ThFischer/OpenSprinkler-Firmware/NodeMCU-74HC595/hardware/74HC595-adapter/F.Cu.pdf

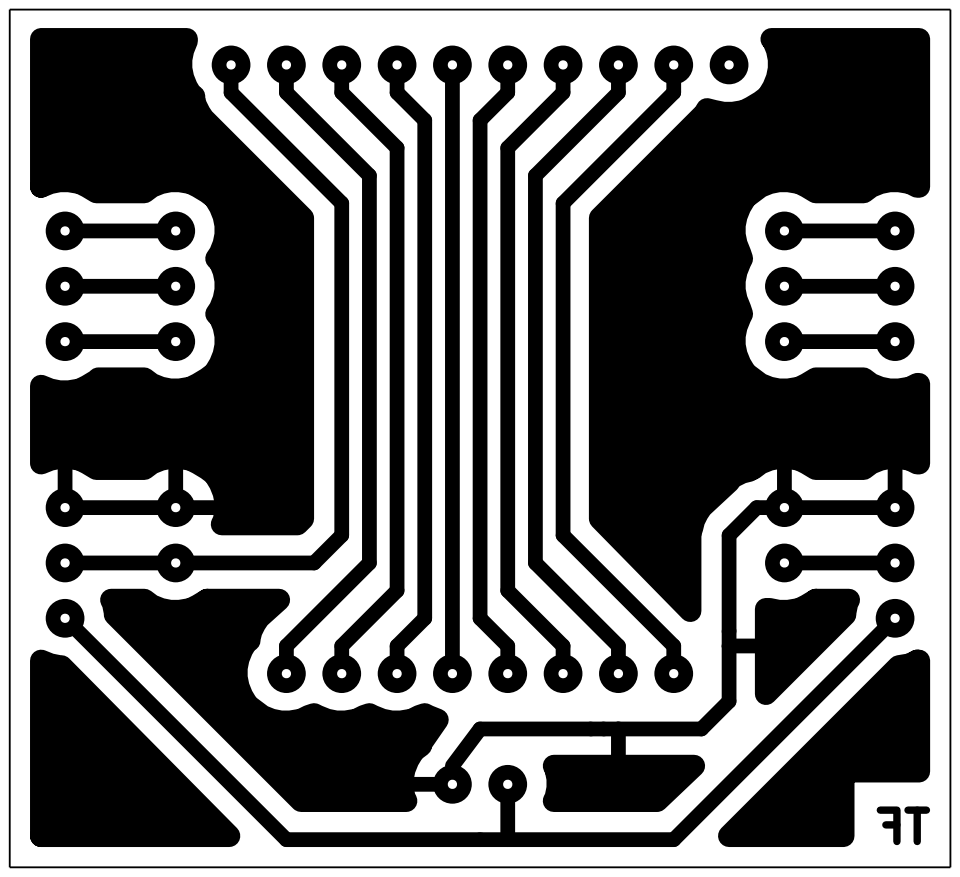
[picture p3: page 1]
