ThFischer/OpenSprinkler-Firmware/NodeMCU-74HC595/hardware/74HC595-adapter/F.SilkS.pdf

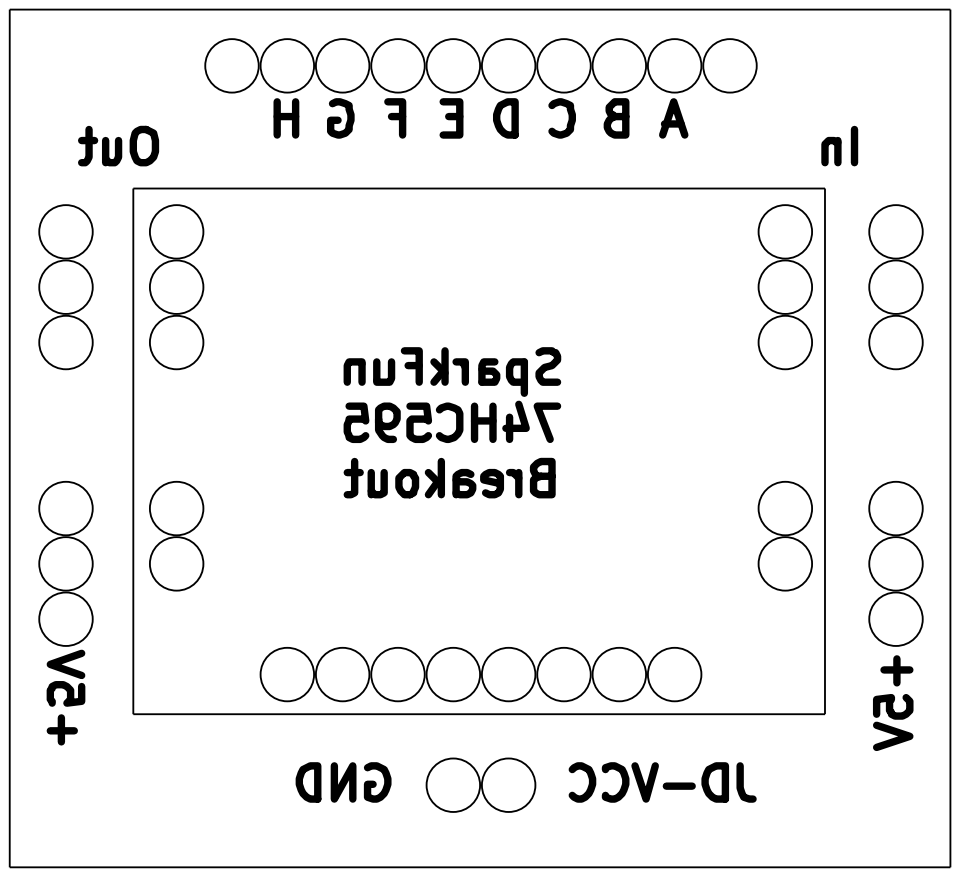
[picture p4: page 1]
