ThFischer/OpenSprinkler-Firmware/NodeMCU-74HC595/hardware/mainboard/B.Cu.pdf

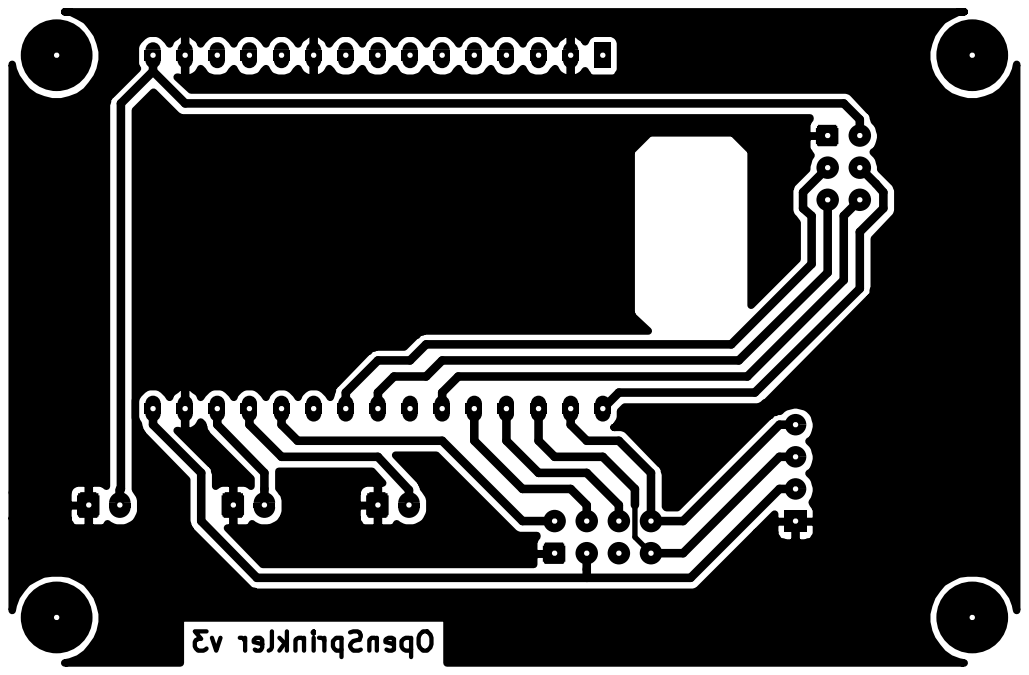
[picture p5: page 1]
