ThFischer/OpenSprinkler-Firmware/NodeMCU-74HC595/hardware/mainboard/F.SilkS.pdf

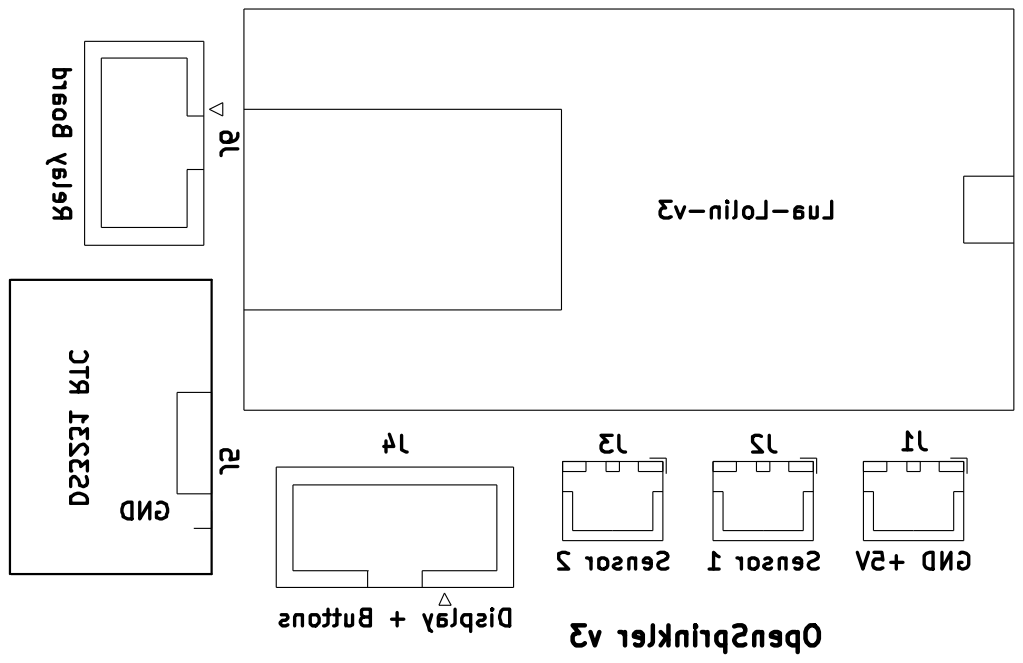
[picture p6: page 1]
