ThFischer/OpenSprinkler-Firmware/NodeMCU-74HC595/hardware/mainboard/mainboard.kicad_pcb

## KiCad design NodeMCU-74HC595/hardware/mainboard/mainboard.kicad_pcb (2022-09-18)

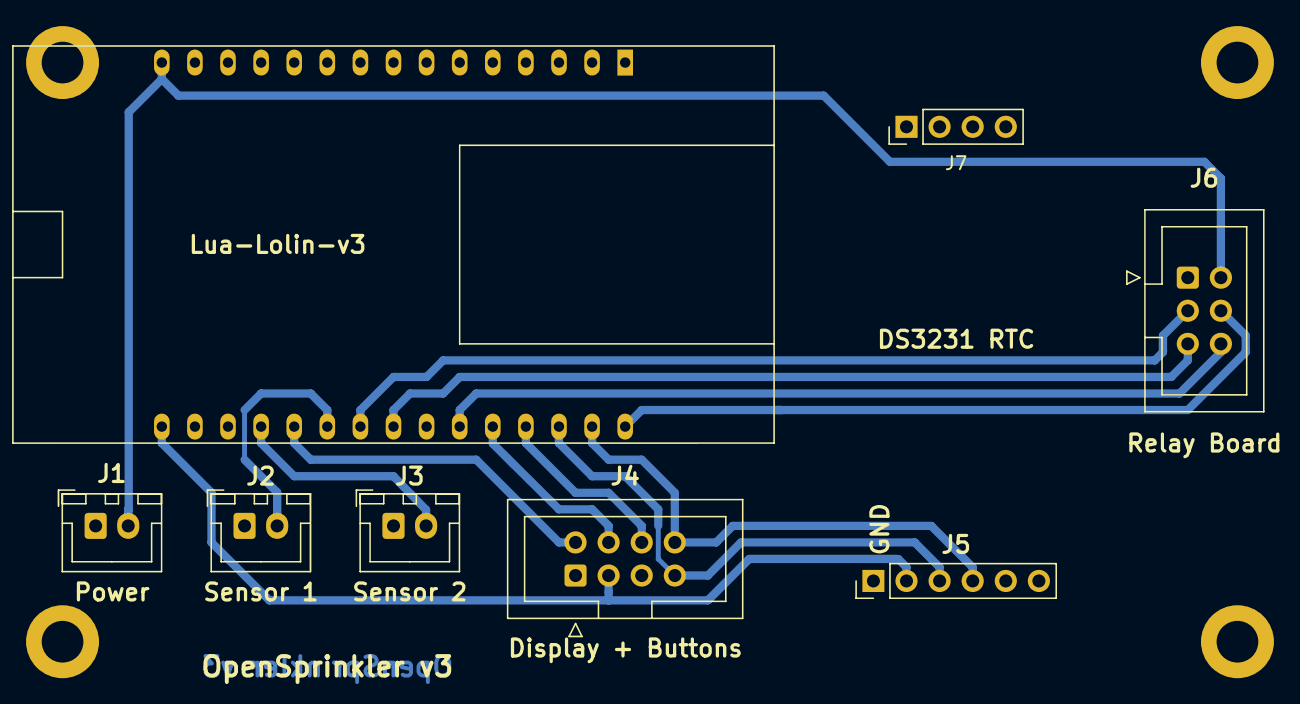
[picture p7: board mainboard.kicad_pcb from above]

Board: 2 copper layers, 12 parts (0 on the bottom side), 14 nets.

Parts:
H1, H2, H3, H4: MountingHole; MountingHole_3.2mm_M3_DIN965_Pad
J1: Power; JST_XH_B2B-XH-A_1x02_P2.50mm_Vertical
J2: Sensor 1; JST_XH_B2B-XH-A_1x02_P2.50mm_Vertical
J3: Sensor 2; JST_XH_B2B-XH-A_1x02_P2.50mm_Vertical
J4: Display + Buttons; IDC-Header_2x04_P2.54mm_Vertical
J5: DS3231 RTC; PinHeader_1x06_P2.54mm_Vertical
J6: Relay Board; IDC-Header_2x03_P2.54mm_Vertical
J7: Conn_01x04_Female; PinHeader_1x04_P2.54mm_Vertical
U1: Lua-Lolin-v3; lua-lolin-v3

Connections:
/3V_2: J4.3, J5.2, U1.16
/3V_3: J6.6, U1.25
/5V: J1.2, J6.2, U1.15
/B1: J4.4, U1.26
/B2: J4.6, U1.27
/B3: J4.2, U1.20
/Clock: J6.3, U1.22
/Data: J6.4, U1.30
/GND: J1.1, J2.1, J3.1, J4.1, J5.1, J6.1, U1.2, U1.10, U1.14, U1.17
/Latch: J6.5, U1.23
/SCL: J4.8, J5.4, U1.29
/SDA: J4.7, J5.3, U1.28
/Sens1: J2.2, U1.21
/Sens2: J3.2, U1.19
