ThFischer/OpenSprinkler-Firmware/NodeMCU-74HC595/hardware/74HC595-adapter/74HC595-adapter.kicad_pcb

## KiCad design NodeMCU-74HC595/hardware/74HC595-adapter/74HC595-adapter.kicad_pcb (2022-09-18)

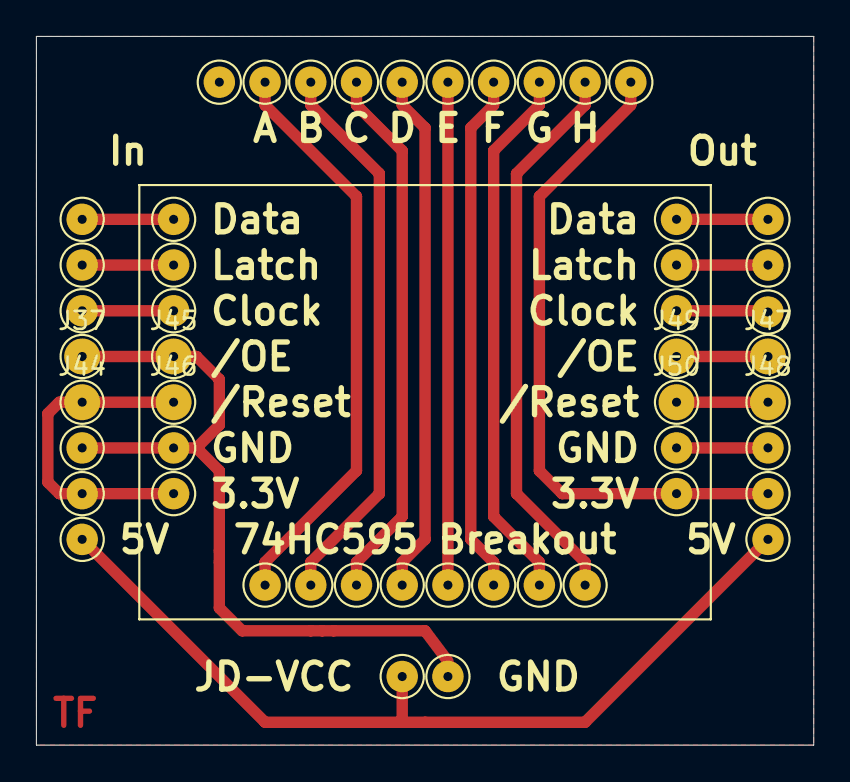
[picture p8: board 74HC595-adapter.kicad_pcb from above]

Board: 2 copper layers, 43.2 x 39.4 mm, 50 parts (0 on the bottom side), 21 nets.

Parts:
J1, J2, J3, J4, J5, J6, J7, J8, J9, J10, J11, J12, J13, J14, J15, J16, J17, J18, J19, J20, J21, J22, J23, J24, J25, J26, J27, J28, J29, J30, J31, J32, J33, J34, J35, J36, J37, J38, J39, J40, J41, J42, J43, J44, J45, J46, J47, J48, J49, J50: Conn_01x01_Male; TestPoint_Pad_D2.0mm

Connections:
/3.3V1: J6.1, J13.1, J44.1, J46.1
/3.3V2: J31.1, J36.1, J42.1
/5V: J5.1, J8.1, J43.1
/A: J15.1, J16.1
/B: J17.1, J18.1
/C: J19.1, J20.1
/Clock1: J3.1, J11.1
/Clock2: J34.1, J40.1
/D: J21.1, J22.1
/Data1: J1.1, J9.1
/Data2: J32.1, J38.1
/E: J23.1, J24.1
/F: J25.1, J26.1
/G: J27.1, J28.1
/GND1: J4.1, J7.1, J12.1, J37.1, J45.1
/GND2: J35.1, J41.1
/H: J29.1, J30.1
/Latch1: J2.1, J10.1
/Latch2: J33.1, J39.1
/OE2: J47.1, J49.1
/Reset2: J48.1, J50.1
