ThFischer/OpenSprinkler-Firmware/defines.h

#define _DEFINES_H
#define ESP12F_RELAY_X4 false
#define NODEMCU_74HC595 true
#define IGNORE_CURR true
#define BUTTON_3_PULLDOWN true
typedef unsigned char byte;
typedef unsigned long ulong;
#define TMP_BUFFER_SIZE      255   // scratch buffer size
#define OS_FW_VERSION  219  // Firmware version: 220 means 2.2.0
#define OS_FW_MINOR      9  // Firmware minor version
#define OS_HW_VERSION_BASE   0x00
#define OSPI_HW_VERSION_BASE 0x40
#define OSBO_HW_VERSION_BASE 0x80
#define SIM_HW_VERSION_BASE  0xC0
#define HW_TYPE_AC           0xAC   // standard 24VAC for 24VAC solenoids only, with triacs
#define HW_TYPE_DC           0xDC   // DC powered, for both DC and 24VAC solenoids, with boost converter and MOSFETs
#define HW_TYPE_LATCH        0x1A   // DC powered, for DC latching solenoids only, with boost converter and H-bridges
#define HW_TYPE_UNKNOWN      0xFF
#define IOPTS_FILENAME        "iopts.dat"   // integer options data file
#define SOPTS_FILENAME        "sopts.dat"   // string options data file
#define STATIONS_FILENAME     "stns.dat"    // stations data file
#define NVCON_FILENAME        "nvcon.dat"   // non-volatile controller data file, see OpenSprinkler.h --> struct NVConData
#define PROG_FILENAME         "prog.dat"    // program data file
#define DONE_FILENAME         "done.dat"    // used to indicate the completion of all files
#define STN_TYPE_STANDARD    0x00
#define STN_TYPE_RF          0x01	// Radio Frequency (RF) station
#define STN_TYPE_REMOTE      0x02	// Remote OpenSprinkler station
#define STN_TYPE_GPIO        0x03	// direct GPIO station
#define STN_TYPE_HTTP        0x04	// HTTP station
#define STN_TYPE_OTHER       0xFF
#define NOTIFY_PROGRAM_SCHED   0x0001
#define NOTIFY_SENSOR1         0x0002
#define NOTIFY_FLOWSENSOR      0x0004
#define NOTIFY_WEATHER_UPDATE  0x0008
#define NOTIFY_REBOOT          0x0010
#define NOTIFY_STATION_OFF     0x0020
#define NOTIFY_SENSOR2         0x0040
#define NOTIFY_RAINDELAY       0x0080
#define NOTIFY_STATION_ON      0x0100
#define HTTP_RQT_SUCCESS			 0
#define HTTP_RQT_NOT_RECEIVED -1
#define HTTP_RQT_CONNECT_ERR	-2
#define HTTP_RQT_TIMEOUT			-3
#define HTTP_RQT_EMPTY_RETURN	-4
#define SENSOR_TYPE_NONE    0x00
#define SENSOR_TYPE_RAIN    0x01	// rain sensor
#define SENSOR_TYPE_FLOW    0x02	// flow sensor
#define SENSOR_TYPE_SOIL    0x03  // soil moisture sensor
#define SENSOR_TYPE_PSWITCH 0xF0	// program switch sensor
#define SENSOR_TYPE_OTHER   0xFF
#define FLOWCOUNT_RT_WINDOW   30    // flow count window (for computing real-time flow rate), 30 seconds
#define REBOOT_CAUSE_NONE   0
#define REBOOT_CAUSE_RESET  1
#define REBOOT_CAUSE_BUTTON 2
#define REBOOT_CAUSE_RSTAP  3
#define REBOOT_CAUSE_TIMER  4
#define REBOOT_CAUSE_WEB    5
#define REBOOT_CAUSE_WIFIDONE     6
#define REBOOT_CAUSE_FWUPDATE     7
#define REBOOT_CAUSE_WEATHER_FAIL 8
#define REBOOT_CAUSE_NETWORK_FAIL 9
#define REBOOT_CAUSE_NTP          10
#define REBOOT_CAUSE_PROGRAM			11
#define REBOOT_CAUSE_POWERON      99
#define WIFI_MODE_AP       0xA9
#define WIFI_MODE_STA      0x2A
#define OS_STATE_INITIAL        0
#define OS_STATE_CONNECTING     1
#define OS_STATE_CONNECTED      2
#define OS_STATE_TRY_CONNECT    3
#define LED_FAST_BLINK 100
#define LED_SLOW_BLINK 500
#if defined(ARDUINO)
	#define MAX_EXT_BOARDS    8  // maximum number of 8-zone expanders (each 16-zone expander counts as 2)
#else
	#define MAX_EXT_BOARDS		24 // allow more zones for linux-based firmwares
#endif
#define MAX_NUM_BOARDS    (1+MAX_EXT_BOARDS)  // maximum number of 8-zone boards including expanders
#define MAX_NUM_STATIONS  (MAX_NUM_BOARDS*8)  // maximum number of stations
#define STATION_NAME_SIZE 32    // maximum number of characters in each station name
#define MAX_SOPTS_SIZE    160   // maximum string option size
#define STATION_SPECIAL_DATA_SIZE  (TMP_BUFFER_SIZE - STATION_NAME_SIZE - 12)
#define DEFAULT_PASSWORD          "a6d82bced638de3def1e9bbb4983225c"  // md5 of 'opendoor'
#define DEFAULT_LOCATION          "42.36,-71.06"	// Boston,MA
#define DEFAULT_JAVASCRIPT_URL    "https://ui.opensprinkler.com/js"
#define DEFAULT_WEATHER_URL       "weather.opensprinkler.com"
#define DEFAULT_IFTTT_URL         "maker.ifttt.com"
#define DEFAULT_EMPTY_STRING      ""
enum {
	IOPT_FW_VERSION=0,// read-only (ro)
	IOPT_TIMEZONE,
	IOPT_USE_NTP,
	IOPT_USE_DHCP,
	IOPT_STATIC_IP1,
	IOPT_STATIC_IP2,
	IOPT_STATIC_IP3,
	IOPT_STATIC_IP4,
	IOPT_GATEWAY_IP1,
	IOPT_GATEWAY_IP2,
	IOPT_GATEWAY_IP3,
	IOPT_GATEWAY_IP4,
	IOPT_HTTPPORT_0,
	IOPT_HTTPPORT_1,
	IOPT_HW_VERSION, //ro
	IOPT_EXT_BOARDS,
	IOPT_SEQUENTIAL_RETIRED, //ro
	IOPT_STATION_DELAY_TIME,
	IOPT_MASTER_STATION,
	IOPT_MASTER_ON_ADJ,
	IOPT_MASTER_OFF_ADJ,
	IOPT_URS_RETIRED, // ro
	IOPT_RSO_RETIRED, // ro
	IOPT_WATER_PERCENTAGE,
	IOPT_DEVICE_ENABLE, // editable through jc
	IOPT_IGNORE_PASSWORD,
	IOPT_DEVICE_ID,
	IOPT_LCD_CONTRAST,
	IOPT_LCD_BACKLIGHT,
	IOPT_LCD_DIMMING,
	IOPT_BOOST_TIME,
	IOPT_USE_WEATHER,
	IOPT_NTP_IP1,
	IOPT_NTP_IP2,
	IOPT_NTP_IP3,
	IOPT_NTP_IP4,
	IOPT_ENABLE_LOGGING,
	IOPT_MASTER_STATION_2,
	IOPT_MASTER_ON_ADJ_2,
	IOPT_MASTER_OFF_ADJ_2,
	IOPT_FW_MINOR, //ro
	IOPT_PULSE_RATE_0,
	IOPT_PULSE_RATE_1,
	IOPT_REMOTE_EXT_MODE, // editable through jc
	IOPT_DNS_IP1,
	IOPT_DNS_IP2,
	IOPT_DNS_IP3,
	IOPT_DNS_IP4,
	IOPT_SPE_AUTO_REFRESH,
	IOPT_IFTTT_ENABLE,
	IOPT_SENSOR1_TYPE,
	IOPT_SENSOR1_OPTION,
	IOPT_SENSOR2_TYPE,
	IOPT_SENSOR2_OPTION,
	IOPT_SENSOR1_ON_DELAY,
	IOPT_SENSOR1_OFF_DELAY,
	IOPT_SENSOR2_ON_DELAY,
	IOPT_SENSOR2_OFF_DELAY,
	IOPT_SUBNET_MASK1,
	IOPT_SUBNET_MASK2,
	IOPT_SUBNET_MASK3,
	IOPT_SUBNET_MASK4,
	IOPT_WIFI_MODE, //ro
	IOPT_RESET,     //ro
	NUM_IOPTS // total number of integer options
};
enum {
	SOPT_PASSWORD=0,
	SOPT_LOCATION,
	SOPT_JAVASCRIPTURL,
	SOPT_WEATHERURL,
	SOPT_WEATHER_OPTS,
	SOPT_IFTTT_KEY,	// todo: make this IFTTT config just like MQTT
	SOPT_STA_SSID,
	SOPT_STA_PASS,
	SOPT_MQTT_OPTS,
	NUM_SOPTS	// total number of string options
};
#define LOGDATA_STATION    0x00
#define LOGDATA_SENSOR1    0x01
#define LOGDATA_RAINDELAY  0x02
#define LOGDATA_WATERLEVEL 0x03
#define LOGDATA_FLOWSENSE  0x04
#define LOGDATA_SENSOR2    0x05
#define LOGDATA_CURRENT    0x80
#undef OS_HW_VERSION
#if defined(__AVR_ATmega1284P__) || defined(__AVR_ATmega1284__) // for OS 2.3
	#define OS_HW_VERSION   (OS_HW_VERSION_BASE+23)
	#define PIN_FREE_LIST		{2,10,12,13,14,15,18,19}  // Free GPIO pins
	#define PIN_BUTTON_1      31    // button 1
	#define PIN_BUTTON_2      30    // button 2
	#define PIN_BUTTON_3      29    // button 3
	#define PIN_RFTX          28    // RF data pin
	#define PORT_RF        PORTA
	#define PINX_RF        PINA3
	#define PIN_SR_LATCH       3    // shift register latch pin
	#define PIN_SR_DATA       21    // shift register data pin
	#define PIN_SR_CLOCK      22    // shift register clock pin
	#define PIN_SR_OE          1    // shift register output enable pin
	#define PIN_LCD_RS        19    // LCD rs pin
	#define PIN_LCD_EN        18    // LCD enable pin
	#define PIN_LCD_D4        20    // LCD d4 pin
	#define PIN_LCD_D5        21    // LCD d5 pin
	#define PIN_LCD_D6        22    // LCD d6 pin
	#define PIN_LCD_D7        23    // LCD d7 pin
	#define PIN_LCD_BACKLIGHT 12    // LCD backlight pin
	#define PIN_LCD_CONTRAST  13    // LCD contrast pin
	#define PIN_BOOST         20    // booster pin
	#define PIN_BOOST_EN      23    // boost voltage enable pin
	#define PIN_ETHER_CS       4    // Ethernet controller chip select pin
	#define PIN_SENSOR1				11		//
	#define PIN_SD_CS          0    // SD card chip select pin
	#define PIN_FLOWSENSOR_INT 1    // flow sensor interrupt pin (INT1)
	#define PIN_EXP_SENSE      4    // expansion board sensing pin (A4)
	#define PIN_CURR_SENSE     7    // current sensing pin (A7)
	#define PIN_CURR_DIGITAL  24    // digital pin index for A7
	#define ETHER_BUFFER_SIZE   2048
	#define 	wdt_reset()   __asm__ __volatile__ ("wdr")  // watchdog timer reset
	#define pinModeExt        pinMode
	#define digitalReadExt    digitalRead
	#define digitalWriteExt   digitalWrite
#elif defined(ESP8266) // for ESP8266
	#define OS_HW_VERSION    (OS_HW_VERSION_BASE+30)
	#define IOEXP_PIN        0x80 // base for pins on main IO expander
	#define MAIN_I2CADDR     0x20 // main IO expander I2C address
	#define ACDR_I2CADDR     0x21 // ac driver I2C address
	#define DCDR_I2CADDR     0x22 // dc driver I2C address
	#define LADR_I2CADDR     0x23 // latch driver I2C address
	#define EXP_I2CADDR_BASE 0x24 // base of expander I2C address
	#define LCD_I2CADDR      0x3C // 128x64 OLED display I2C address
	#define PIN_CURR_SENSE    A0
	#define PIN_FREE_LIST     {} // no free GPIO pin at the moment
	#define ETHER_BUFFER_SIZE   2048
	#define PIN_ETHER_CS       16 // ENC28J60 CS (chip select pin) is 16 on OS 3.2.
	extern byte PIN_BUTTON_1;
	extern byte PIN_BUTTON_2;
	extern byte PIN_BUTTON_3;
	extern byte PIN_RFRX;
	extern byte PIN_RFTX;
	extern byte PIN_BOOST;
	extern byte PIN_BOOST_EN;
	extern byte PIN_LATCH_COM;
	extern byte PIN_LATCH_COMA;
	extern byte PIN_LATCH_COMK;
	extern byte PIN_SENSOR1;
	extern byte PIN_SENSOR2;
	extern byte PIN_IOEXP_INT;
	#define V0_PIN_BUTTON_1      IOEXP_PIN+1 // button 1
	#define V0_PIN_BUTTON_2      0           // button 2
	#define V0_PIN_BUTTON_3      IOEXP_PIN+3 // button 3
	#define V0_PIN_RFRX          14
	#define V0_PIN_PWR_RX        IOEXP_PIN+0
	#define V0_PIN_RFTX          16
	#define V0_PIN_PWR_TX        IOEXP_PIN+2
	#define V0_PIN_BOOST         IOEXP_PIN+6
	#define V0_PIN_BOOST_EN      IOEXP_PIN+7
	#define V0_PIN_SENSOR1       12 // sensor 1
	#define V0_PIN_SENSOR2       13 // sensor 2
	#define V1_IO_CONFIG         0x1F00 // config bits
	#define V1_IO_OUTPUT         0x1F00 // output bits
	#define V1_PIN_BUTTON_1      IOEXP_PIN+10 // button 1
	#define V1_PIN_BUTTON_2      IOEXP_PIN+11 // button 2
	#define V1_PIN_BUTTON_3      IOEXP_PIN+12 // button 3
	#define V1_PIN_RFRX          14
	#define V1_PIN_RFTX          16
	#define V1_PIN_IOEXP_INT     12
	#define V1_PIN_BOOST         IOEXP_PIN+13
	#define V1_PIN_BOOST_EN      IOEXP_PIN+14
	#define V1_PIN_LATCH_COM     IOEXP_PIN+15
	#define V1_PIN_SENSOR1       IOEXP_PIN+8 // sensor 1
	#define V1_PIN_SENSOR2       IOEXP_PIN+9 // sensor 2
	#define V2_IO_CONFIG         0x1000 // config bits
	#define V2_IO_OUTPUT         0x1E00 // output bits
	#define V2_PIN_BUTTON_1      2 // button 1
	#define V2_PIN_BUTTON_2      0 // button 2
		#define V2_PIN_BUTTON_3    15 // button 3
		#define V2_PIN_RFTX        IOEXP_PIN+12
		#define PIN_SRDAT          16  // "D0"
		#define PIN_SRLAT          14  // "D5"
		#define PIN_SRCLK          12  // "D6"
	#define V2_PIN_BOOST         IOEXP_PIN+13
	#define V2_PIN_BOOST_EN      IOEXP_PIN+14
	#define V2_PIN_LATCH_COMA    IOEXP_PIN+8  // latch COM+ (anode)
	#define V2_PIN_SRLAT         IOEXP_PIN+9  // shift register latch
	#define V2_PIN_SRCLK         IOEXP_PIN+10 // shift register clock
	#define V2_PIN_SRDAT         IOEXP_PIN+11 // shift register data
	#define V2_PIN_LATCH_COMK    IOEXP_PIN+15 // latch COM- (cathode)
		#define V2_PIN_SENSOR1     13 // sensor 1
		#define V2_PIN_SENSOR2     3  // sensor 2
#elif defined(OSPI) // for OSPi
	#define OS_HW_VERSION    OSPI_HW_VERSION_BASE
	#define PIN_SR_LATCH      22    // shift register latch pin
	#define PIN_SR_DATA       27    // shift register data pin
	#define PIN_SR_DATA_ALT   21    // shift register data pin (alternative, for RPi 1 rev. 1 boards)
	#define PIN_SR_CLOCK       4    // shift register clock pin
	#define PIN_SR_OE         17    // shift register output enable pin
	#define PIN_SENSOR1				14
	#define PIN_SENSOR2				23
	#define PIN_RFTX          15    // RF transmitter pin
	#define PIN_FREE_LIST		{5,6,7,8,9,10,11,12,13,16,18,19,20,21,23,24,25,26}  // free GPIO pins
	#define ETHER_BUFFER_SIZE   16384
#elif defined(OSBO) // for OSBo
	#define OS_HW_VERSION    OSBO_HW_VERSION_BASE
	#define PIN_SR_LATCH      60    // P9_12, shift register latch pin
	#define PIN_SR_DATA       30    // P9_11, shift register data pin
	#define PIN_SR_CLOCK      31    // P9_13, shift register clock pin
	#define PIN_SR_OE         50    // P9_14, shift register output enable pin
	#define PIN_SENSOR1				48
	#define PIN_RFTX          51    // RF transmitter pin
	#define PIN_FREE_LIST     {38,39,34,35,45,44,26,47,27,65,63,62,37,36,33,32,61,86,88,87,89,76,77,74,72,73,70,71}
	#define ETHER_BUFFER_SIZE   16384
#else // for demo / simulation
	#if defined(DEMO)
		#define OS_HW_VERSION 255   // assign hardware number 255 to DEMO firmware
	#else
		#define OS_HW_VERSION SIM_HW_VERSION_BASE
	#endif
	#define PIN_SR_LATCH    0
	#define PIN_SR_DATA     0
	#define PIN_SR_CLOCK    0
	#define PIN_SR_OE       0
	#define PIN_SENSOR1			0
	#define PIN_SENSOR2			0
	#define PIN_RFTX     0
	#define PIN_FREE_LIST	{}
	#define ETHER_BUFFER_SIZE   16384
#endif
	#define DEBUG_BEGIN(x)   {}
	#define DEBUG_PRINT(x)   {}
	#define DEBUG_PRINTLN(x) {}
#if !defined(ARDUINO)
	#include <stdio.h>
	#include <stdlib.h>
	#include <string.h>
	#include <stddef.h>
	inline void itoa(int v,char *s,int b)   {sprintf(s,"%d",v);}
	inline void ultoa(unsigned long v,char *s,int b) {sprintf(s,"%lu",v);}
	#define now()       time(0)
	#define pgm_read_byte(x) *(x)
	#define PSTR(x)      x
	#define F(x)				 x
	#define strcat_P     strcat
	#define strcpy_P     strcpy
	#define sprintf_P    sprintf
	#include<string>
	#define String       string
	using namespace std;
	#define PROGMEM
	typedef const char* PGM_P;
	typedef unsigned char   uint8_t;
	typedef short           int16_t;
	typedef unsigned short  uint16_t;
	typedef bool boolean;
	#define pinModeExt      pinMode
	#define digitalReadExt  digitalRead
	#define digitalWriteExt digitalWrite
#endif
#define BUTTON_1            0x01
#define BUTTON_2            0x02
#define BUTTON_3            0x04
#define BUTTON_NONE         0x00  // no button pressed
#define BUTTON_MASK         0x0F  // button status mask
#define BUTTON_FLAG_HOLD    0x80  // long hold flag
#define BUTTON_FLAG_DOWN    0x40  // down flag
#define BUTTON_FLAG_UP      0x20  // up flag
#define BUTTON_DELAY_MS        1  // short delay (milliseconds)
#define BUTTON_HOLD_MS      1000  // long hold expiration time (milliseconds)
#define BUTTON_WAIT_NONE       0  // do not wait, return value immediately
#define BUTTON_WAIT_RELEASE    1  // wait until button is release
#define BUTTON_WAIT_HOLD       2  // wait until button hold time expires
#define DISPLAY_MSG_MS      2000  // message display time (milliseconds)
