ThFischer/OpenSprinkler-Firmware/(commit log)

2022-01-09 * Add KiCad Schematic & PCB * Change Sensor GPIOs
    [mainboard.kicad_pcb, mainboard.sch, relayboard.kicad_pcb, relayboard.sch]
2022-09-18 fix kicad
    [relayboard.kicad_pcb]
2022-09-18 Update to KiCad 6, improve ReadMe
    [74HC595-adapter.kicad_pcb, 74HC595-adapter.kicad_sch, mainboard.kicad_pcb, mainboard.kicad_sch, mainboard.sch, relayboard.kicad_pcb, relayboard.sch]
